cfallin/nixie3/FT231XS-R/FT231XS-R.step

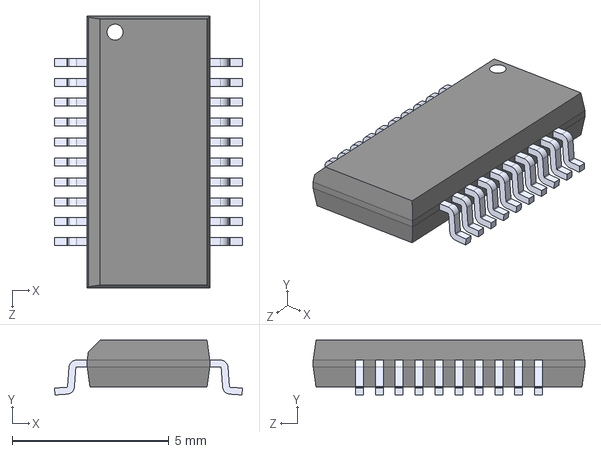
[picture p1: CAD file, 2023-09-27]
FT231XS-R/FT231XS-R.step
5.99 x 1.75 x 8.66 mm
