cfallin/nixie3/(list of files, drawings)

Other design files:
freerouting.dsn
