cfallin/nixie3/nixie3.kicad_pcb

## KiCad design nixie3.kicad_pcb (2023-10-08)

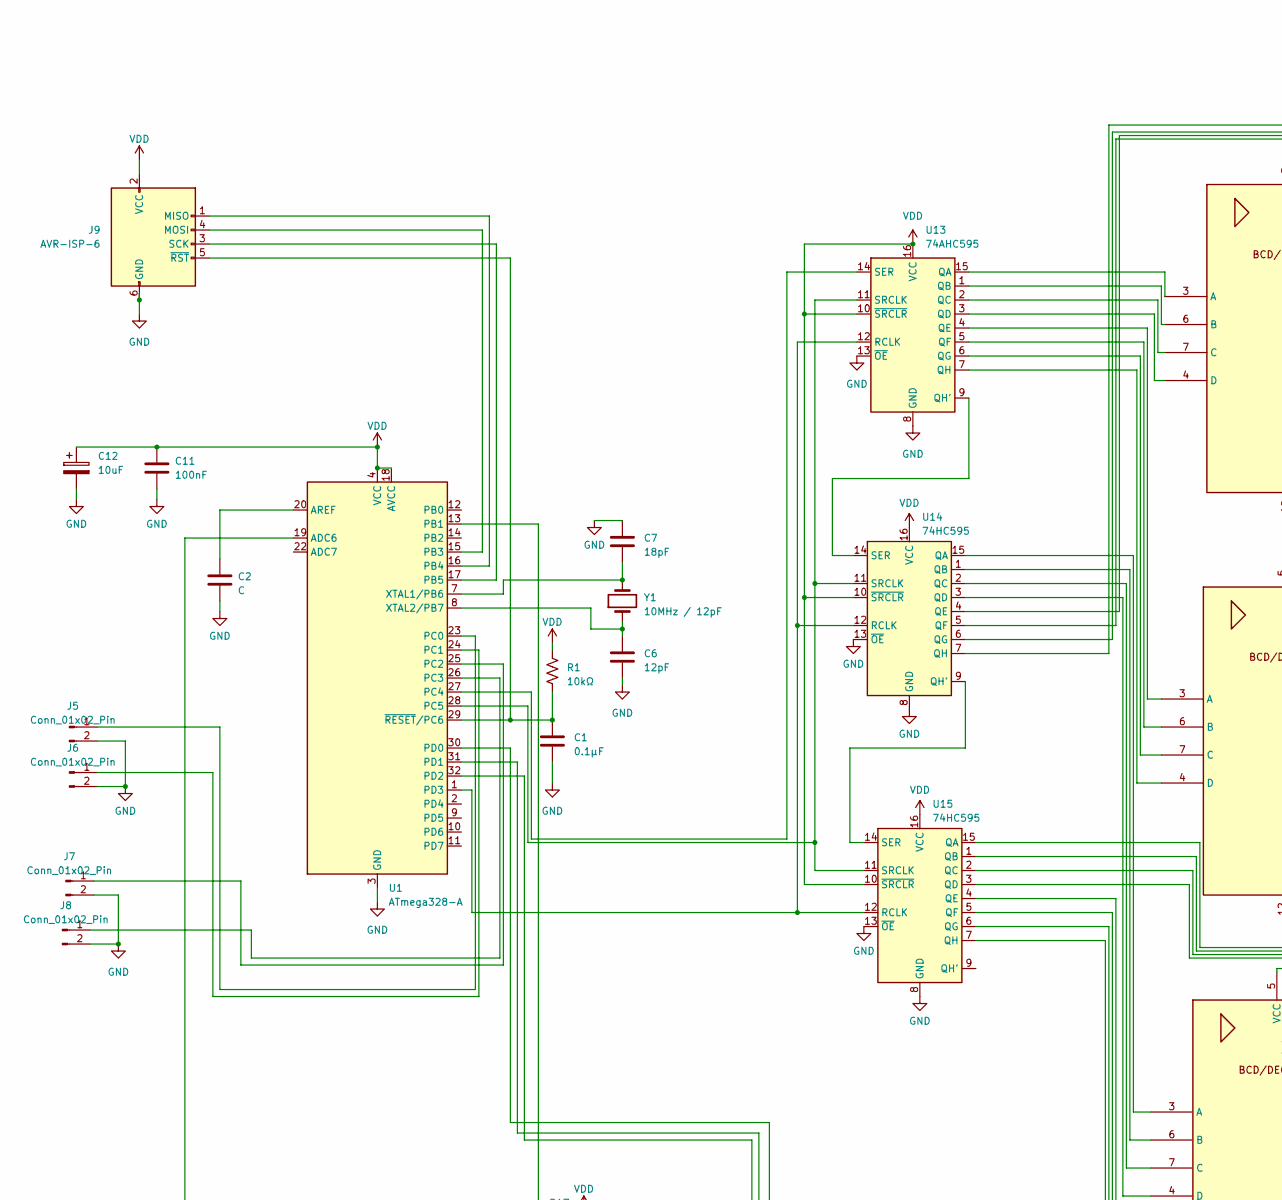
[picture p2: schematic nixie3.kicad_sch, part in row 1, column 1]

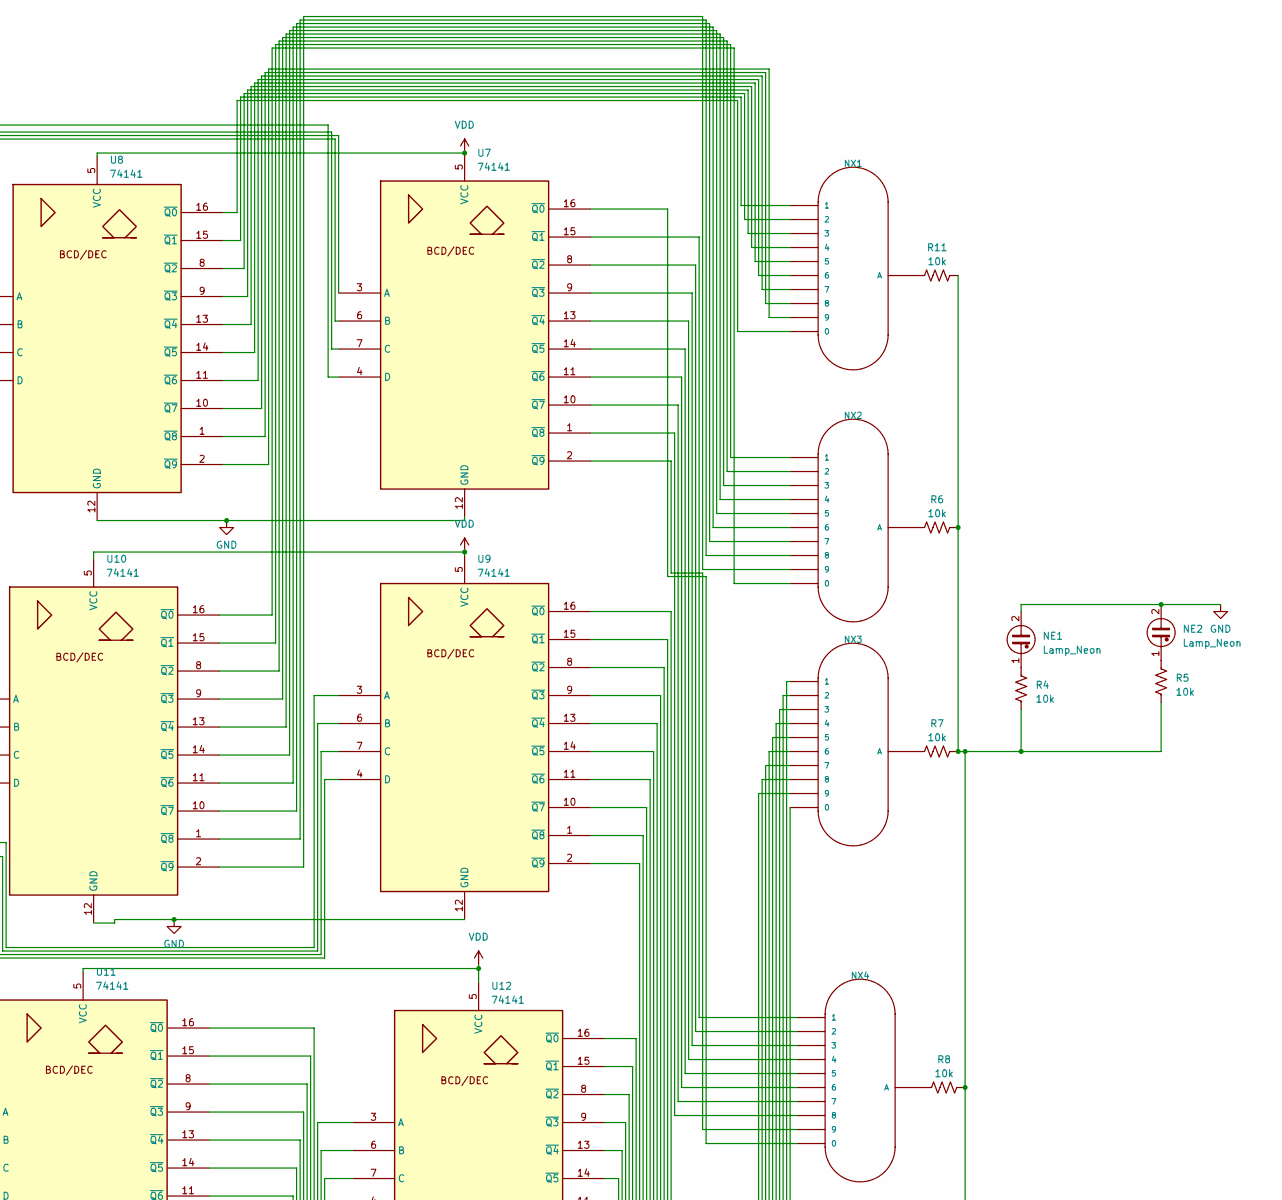
[picture p3: schematic nixie3.kicad_sch, part in row 1, column 2]

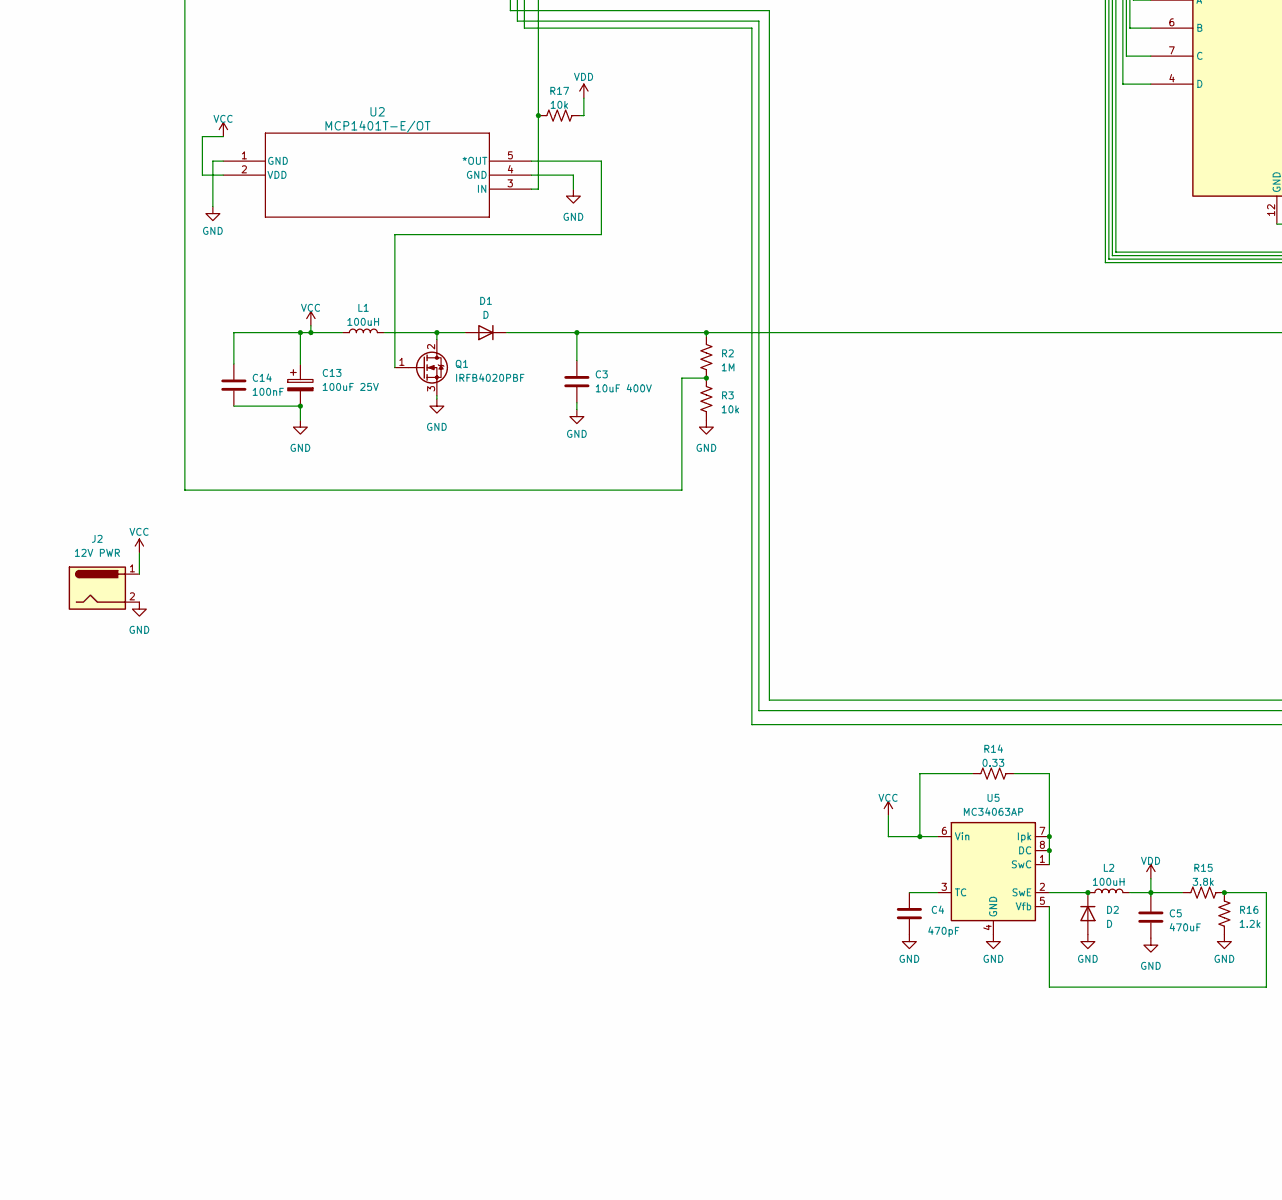
[picture p4: schematic nixie3.kicad_sch, part in row 2, column 1]

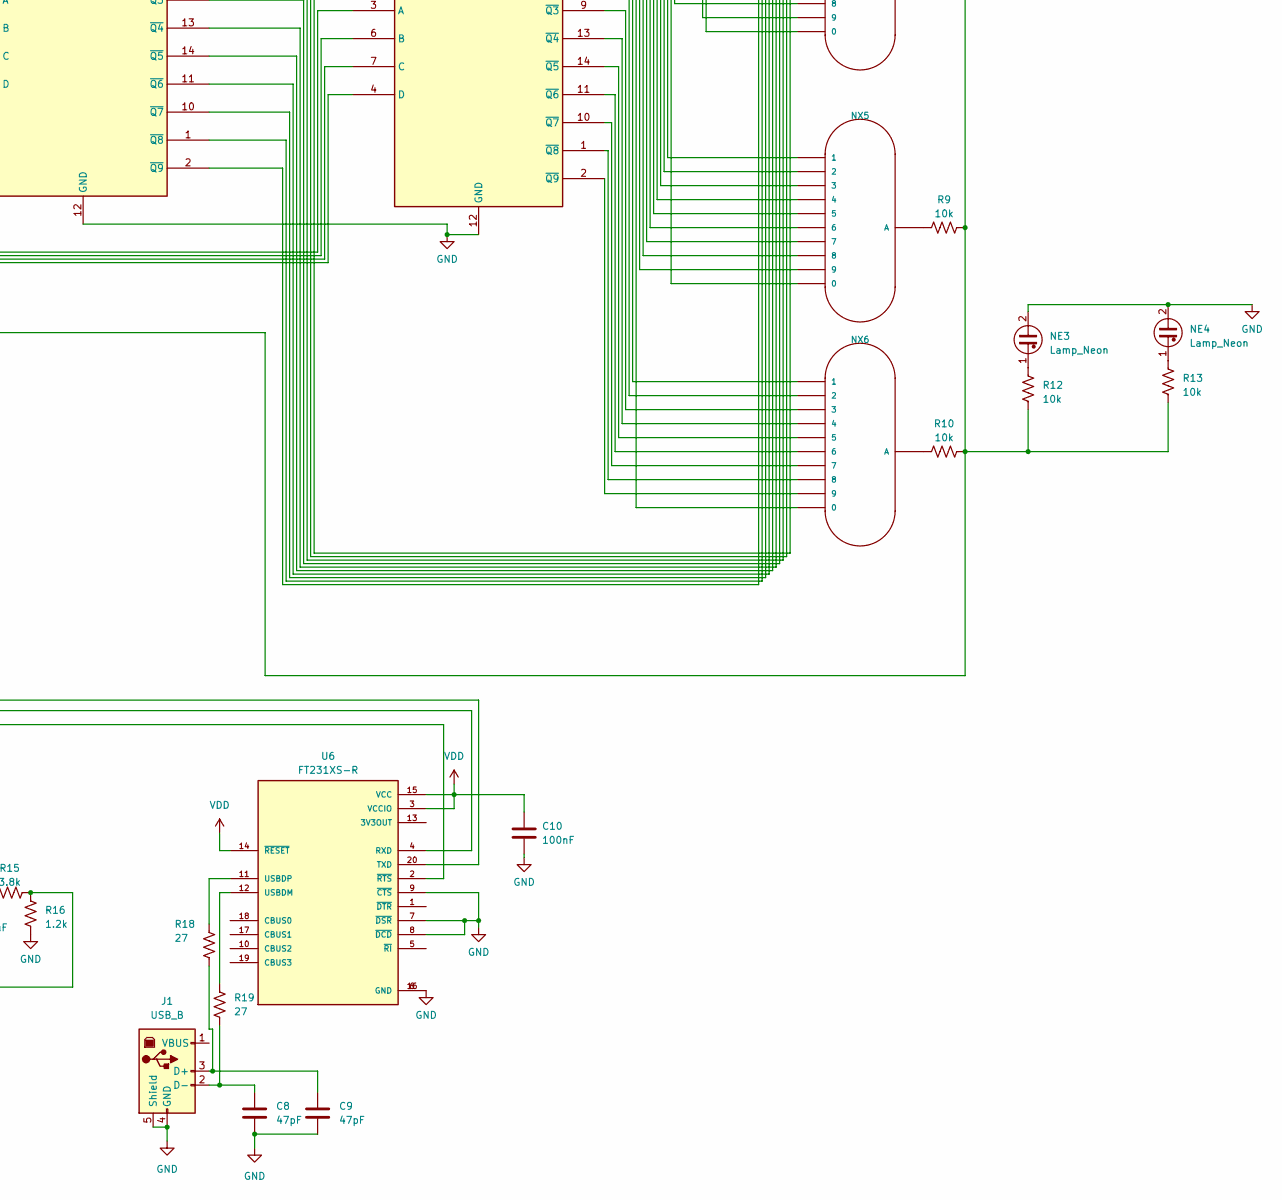
[picture p5: schematic nixie3.kicad_sch, part in row 2, column 2]

Parts:
C1: 0.1µF; CP_Radial_D4.0mm_P1.50mm
C2: C; CP_Radial_D4.0mm_P1.50mm
C3: 10uF 400V; CP_Radial_D8.0mm_P5.00mm
C4: 470pF; C_Disc_D6.0mm_W2.5mm_P5.00mm
C5: 470uF; CP_Radial_D8.0mm_P5.00mm
C6: 12pF; C_Disc_D5.0mm_W2.5mm_P5.00mm
C7: 18pF; C_Disc_D5.0mm_W2.5mm_P5.00mm
C8, C9: 47pF; CP_Radial_D5.0mm_P2.50mm
C10, C11, C14: 100nF; CP_Radial_D5.0mm_P2.50mm
C12: 10uF; CP_Radial_D5.0mm_P2.50mm
C13: 100uF 25V; CP_Radial_D8.0mm_P5.00mm
D1, D2: D; D_DO-15_P12.70mm_Horizontal
J1: USB_B; USB_B_OST_USB-B1HSxx_Horizontal
J2: 12V PWR; BarrelJack_Horizontal
J5, J6, J7, J8: Conn_01x02_Pin; PinHeader_1x02_P2.54mm_Vertical
J9: AVR-ISP-6; PinHeader_2x03_P2.54mm_Vertical
L1, L2: 100uH; L_Toroid_Vertical_L16.0mm_W8.0mm_P7.62mm
NE1, NE2, NE3, NE4: Lamp_Neon; LED_D3.0mm
NX1, NX2, NX3, NX4, NX5, NX6: IN-12A; nixies-us-IN-12
Q1: IRFB4020PBF; TO-220-3_Vertical
R1: 10kΩ; R_Axial_DIN0204_L3.6mm_D1.6mm_P1.90mm_Vertical
R2: 1M; R_Axial_DIN0207_L6.3mm_D2.5mm_P2.54mm_Vertical
R3, R4, R5, R6, R7, R8, R9, R10, R11, R12, R13, R17: 10k; R_Axial_DIN0207_L6.3mm_D2.5mm_P2.54mm_Vertical
R14: 0.33; R_Axial_DIN0207_L6.3mm_D2.5mm_P2.54mm_Vertical
R15: 3.8k; R_Axial_DIN0207_L6.3mm_D2.5mm_P2.54mm_Vertical
R16: 1.2k; R_Axial_DIN0207_L6.3mm_D2.5mm_P2.54mm_Vertical
R18, R19: 27; R_Axial_DIN0204_L3.6mm_D1.6mm_P2.54mm_Vertical
U1: ATmega328-A; TQFP-32_7x7mm_P0.8mm
U2: MCP1401T-E/OT; SOT-23-5_MC_MCH
U5: MC34063AP; DIP-8_W7.62mm
U6: FT231XS-R; SOP63P599X175-20N; PARTREV 1.2; DigiKey_Part_Number 768-1129-2-ND
U7, U8, U9, U10, U11, U12: 74141; DIP-16_W7.62mm
U13: 74AHC595; DIP-16_W7.62mm
U14, U15: 74HC595; DIP-16_W7.62mm
Y1: 10MHz / 12pF; Crystal_HC49-U_Vertical

Connections:
GND: C1.2, C2.2, C3.2, C4.2, C5.2, C6.1, C7.1, C8.2, C9.2, C10.2, C11.2, C12.2, C13.2, C14.2, D2.2 (A), J1.4 (GND), J1.5 (Shield), J2.2, J5.2, J6.2, J7.2, J8.2, J9.6 (GND), NE1.2, NE2.2, NE3.2, NE4.2, Q1.3 (S), R3.2, R16.2, U1.3 (GND), U1.5 (GND), U1.21 (GND), U2.1 (GND), U2.4 (GND), U5.4 (GND), U6.6 (GND), U6.7 (~DSR), U6.8 (~DCD), U6.9 (~CTS), U6.16 (GND), U7.12 (GND), U8.12 (GND), U9.12 (GND), U10.12 (GND), U11.12 (GND), U12.12 (GND), U13.8 (GND), U13.13 (~OE), U14.8 (GND), U14.13 (~OE), U15.8 (GND), U15.13 (~OE)
unnamed: D1.2 (A), L1.2, Q1.2 (D)
unnamed: C3.1, D1.1 (K), R2.1, R4.1, R5.2, R6.2, R7.2, R8.2, R9.2, R10.2, R11.2, R12.2, R13.2
unnamed: D2.1 (K), L2.1, U5.2 (SwE)
unnamed: C9.1, J1.3 (D+), R18.2
unnamed: C8.1, J1.2 (D-), R19.2
unnamed: J5.1, U1.23 (PC0)
unnamed: J6.1, U1.24 (PC1)
unnamed: J7.1, U1.25 (PC2)
unnamed: J8.1, U1.26 (PC3)
unnamed: J9.1 (MISO), U1.16 (PB4)
unnamed: J9.4 (MOSI), U1.15 (PB3)
unnamed: J9.3 (SCK), U1.17 (PB5)
unnamed: C1.1, J9.5 (~RST), R1.2, U1.29 (~RESET/PC6)
unnamed: NE1.1, R4.2
unnamed: NE2.1, R5.1
unnamed: NE3.1, R12.1
unnamed: NE4.1, R13.1
unnamed: NX1.A, R11.1
unnamed: NX2.A, R6.1
unnamed: NX3.A, R7.1
unnamed: NX4.A, R8.1
unnamed: NX5.A, R9.1
unnamed: NX6.A, R10.1
unnamed: Q1.1 (G), U2.5 (*OUT)
unnamed: R2.2, R3.1, U1.19 (ADC6)
unnamed: C2.1, U1.20 (AREF)
unnamed: R17.1, U1.13 (PB1), U2.3 (IN)
unnamed: U1.27 (PC4), U13.14 (SER)
unnamed: U1.28 (PC5), U13.11 (SRCLK), U14.11 (SRCLK), U15.11 (SRCLK)
unnamed: U1.30 (PD0), U6.20 (TXD)
unnamed: U1.31 (PD1), U6.4 (RXD)
unnamed: U1.32 (PD2), U6.2 (~RTS)
unnamed: U1.1 (PD3), U13.12 (RCLK), U14.12 (RCLK), U15.12 (RCLK)
unnamed: C7.2, U1.7 (XTAL1/PB6), Y1.2
unnamed: C6.2, U1.8 (XTAL2/PB7), Y1.1
unnamed: R14.2, U5.1 (SwC), U5.7 (Ipk), U5.8 (DC)
unnamed: C4.1, U5.3 (TC)
unnamed: R15.2, R16.1, U5.5 (Vfb)
unnamed: R19.1, U6.12 (USBDM)
unnamed: R18.1, U6.11 (USBDP)
unnamed: NX4.0, U7.16 (~Q0)
unnamed: NX4.1, U7.15 (~Q1)
unnamed: NX4.2, U7.8 (~Q2)
unnamed: NX4.3, U7.9 (~Q3)
unnamed: NX4.4, U7.13 (~Q4)
unnamed: NX4.5, U7.14 (~Q5)
unnamed: NX4.6, U7.11 (~Q6)
unnamed: NX4.7, U7.10 (~Q7)
unnamed: NX4.8, U7.1 (~Q8)
unnamed: NX4.9, U7.2 (~Q9)
unnamed: NX1.0, U8.16 (~Q0)
unnamed: NX1.1, U8.15 (~Q1)
unnamed: NX1.2, U8.8 (~Q2)
unnamed: NX1.3, U8.9 (~Q3)
unnamed: NX1.4, U8.13 (~Q4)
unnamed: NX1.5, U8.14 (~Q5)
unnamed: NX1.6, U8.11 (~Q6)
unnamed: NX1.7, U8.10 (~Q7)
unnamed: NX1.8, U8.1 (~Q8)
unnamed: NX1.9, U8.2 (~Q9)
unnamed: NX5.0, U9.16 (~Q0)
unnamed: NX5.1, U9.15 (~Q1)
unnamed: NX5.2, U9.8 (~Q2)
unnamed: NX5.3, U9.9 (~Q3)
unnamed: NX5.4, U9.13 (~Q4)
unnamed: NX5.5, U9.14 (~Q5)
unnamed: NX5.6, U9.11 (~Q6)
unnamed: NX5.7, U9.10 (~Q7)
unnamed: NX5.8, U9.1 (~Q8)
unnamed: NX5.9, U9.2 (~Q9)
unnamed: U10.3 (A), U13.4 (QE)
unnamed: U10.6 (B), U13.5 (QF)
unnamed: U10.7 (C), U13.6 (QG)
unnamed: U10.4 (D), U13.7 (QH)
unnamed: NX2.0, U10.16 (~Q0)
unnamed: NX2.1, U10.15 (~Q1)
unnamed: NX2.2, U10.8 (~Q2)
unnamed: NX2.3, U10.9 (~Q3)
unnamed: NX2.4, U10.13 (~Q4)
unnamed: NX2.5, U10.14 (~Q5)
unnamed: NX2.6, U10.11 (~Q6)
unnamed: NX2.7, U10.10 (~Q7)
unnamed: NX2.8, U10.1 (~Q8)
unnamed: NX2.9, U10.2 (~Q9)
unnamed: U11.3 (A), U14.15 (QA)
unnamed: U11.6 (B), U14.1 (QB)
unnamed: U11.7 (C), U14.2 (QC)
unnamed: U11.4 (D), U14.3 (QD)
unnamed: NX3.0, U11.16 (~Q0)
unnamed: NX3.1, U11.15 (~Q1)
unnamed: NX3.2, U11.8 (~Q2)
unnamed: NX3.3, U11.9 (~Q3)
unnamed: NX3.4, U11.13 (~Q4)
unnamed: NX3.5, U11.14 (~Q5)
unnamed: NX3.6, U11.11 (~Q6)
unnamed: NX3.7, U11.10 (~Q7)
unnamed: NX3.8, U11.1 (~Q8)
unnamed: NX3.9, U11.2 (~Q9)
unnamed: U12.3 (A), U15.4 (QE)
unnamed: U12.6 (B), U15.5 (QF)
unnamed: U12.7 (C), U15.6 (QG)
unnamed: U12.4 (D), U15.7 (QH)
unnamed: NX6.0, U12.16 (~Q0)
unnamed: NX6.1, U12.15 (~Q1)
unnamed: NX6.2, U12.8 (~Q2)
unnamed: NX6.3, U12.9 (~Q3)
unnamed: NX6.4, U12.13 (~Q4)
unnamed: NX6.5, U12.14 (~Q5)
unnamed: NX6.6, U12.11 (~Q6)
unnamed: NX6.7, U12.10 (~Q7)
unnamed: NX6.8, U12.1 (~Q8)
unnamed: NX6.9, U12.2 (~Q9)
unnamed: U8.3 (A), U13.15 (QA)
unnamed: U8.6 (B), U13.1 (QB)
unnamed: U8.7 (C), U13.2 (QC)
unnamed: U8.4 (D), U13.3 (QD)
unnamed: U13.9 (QH'), U14.14 (SER)
unnamed: U7.3 (A), U14.4 (QE)
unnamed: U7.6 (B), U14.5 (QF)
unnamed: U7.7 (C), U14.6 (QG)
unnamed: U14.9 (QH'), U15.14 (SER)
unnamed: U7.4 (D), U14.7 (QH)
unnamed: U9.3 (A), U15.15 (QA)
unnamed: U9.6 (B), U15.1 (QB)
unnamed: U9.7 (C), U15.2 (QC)
unnamed: U9.4 (D), U15.3 (QD)
VCC: C13.1, C14.1, J2.1, L1.1, R14.1, U2.2 (VDD), U5.6 (Vin)
VDD: C5.1, C10.1, C11.1, C12.1, J9.2 (VCC), L2.2, R1.1, R15.1, R17.2, U1.4 (VCC), U1.6 (VCC), U1.18 (AVCC), U6.3 (VCCIO), U6.14 (~RESET), U6.15 (VCC), U7.5 (VCC), U8.5 (VCC), U9.5 (VCC), U10.5 (VCC), U11.5 (VCC), U12.5 (VCC), U13.10 (~SRCLR), U13.16 (VCC), U14.10 (~SRCLR), U14.16 (VCC), U15.10 (~SRCLR), U15.16 (VCC)

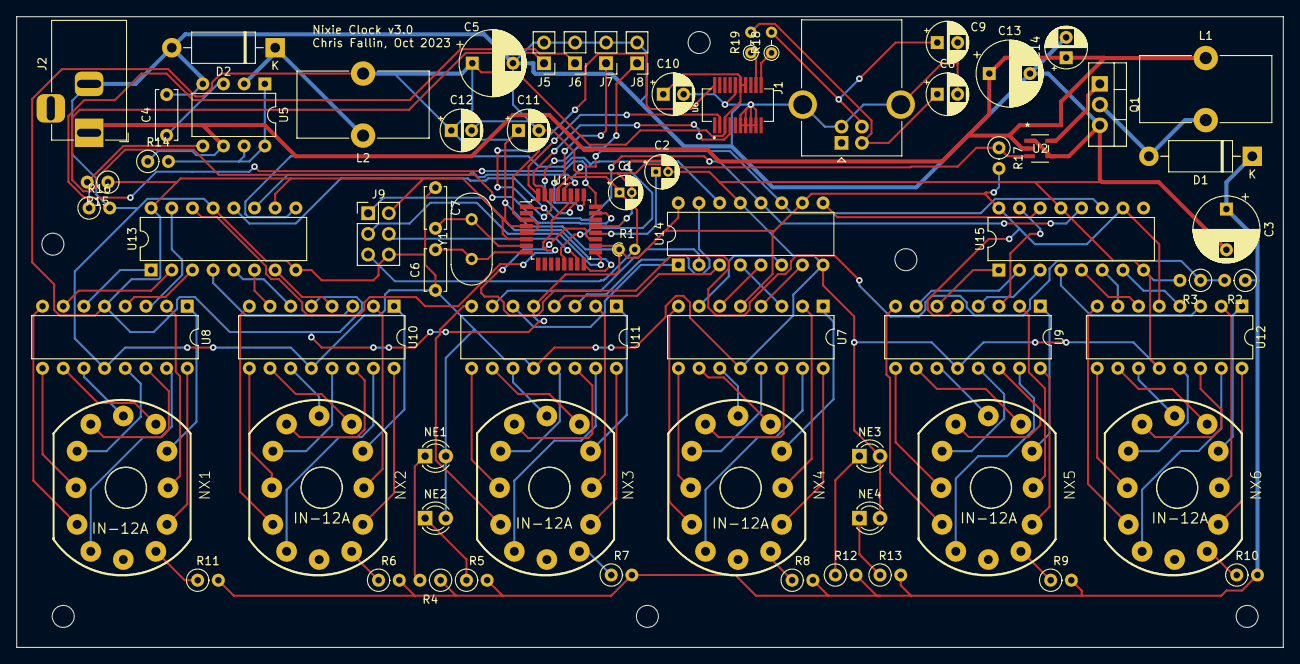
[picture p6: board nixie3.kicad_pcb from above]

Board: 2 copper layers, 155.6 x 77.5 mm, 69 parts (0 on the bottom side), 129 nets.
