cfallin/nixie3/firmware/switches.c

#include <avr/io.h>

#include "nixie.h"

void init_switches() {
    DDRC &= ~0x0f;  // PC0..PC3 are inputs.
    PORTC |= 0x0f;  // set pullups.
    DIDR0 = 0;      // don't disable any digital inputs, even though the ADC is on.
}

// Active-low (zero bit) for pressed button/flipped switch, as from
// hardware (switches are from ground to input pin, and input pin has
// pull-up resistor).
int switch_debounce0 = 0;
int switch_debounce1 = 0;
int switch_debounce2 = 0;
// Active-high (one bit) for pressed button/flipped switch.
int switches = 0;

void read_switches() {
    switch_debounce2 = switch_debounce1;
    switch_debounce1 = switch_debounce0;
    switch_debounce0 = PINC & 0x0f;
    switches = ~(switch_debounce2 | switch_debounce1 | switch_debounce0);
}
