cfallin/nixie3/(commit log)

2023-05-12 Initial commit.
    [freerouting.dsn, nixie3.kicad_pcb, nixie3.kicad_sch, temp-freerouting.dsn]
2023-10-06 board update
    [nixie3.kicad_pcb, nixie3.kicad_sch]
2023-10-08 final board layout.
    [nixie3.kicad_pcb, nixie3.kicad_sch]
2023-10-08 final board, zip file
2023-10-08 Added final files.
    [nixie3-B_Cu.gbr, nixie3-B_Mask.gbr, nixie3-B_Paste.gbr, nixie3-B_Silkscreen.gbr, nixie3-Edge_Cuts.gbr, nixie3-F_Cu.gbr, nixie3-F_Mask.gbr, nixie3-F_Paste.gbr]
2023-10-25 power regulation to 160V
2023-10-25 Power adjustments.
2023-10-30 Update buttons.
